MaxwellMrks/Neon-Plasma-Tube-Entropy-Source-/3195khz.jpg

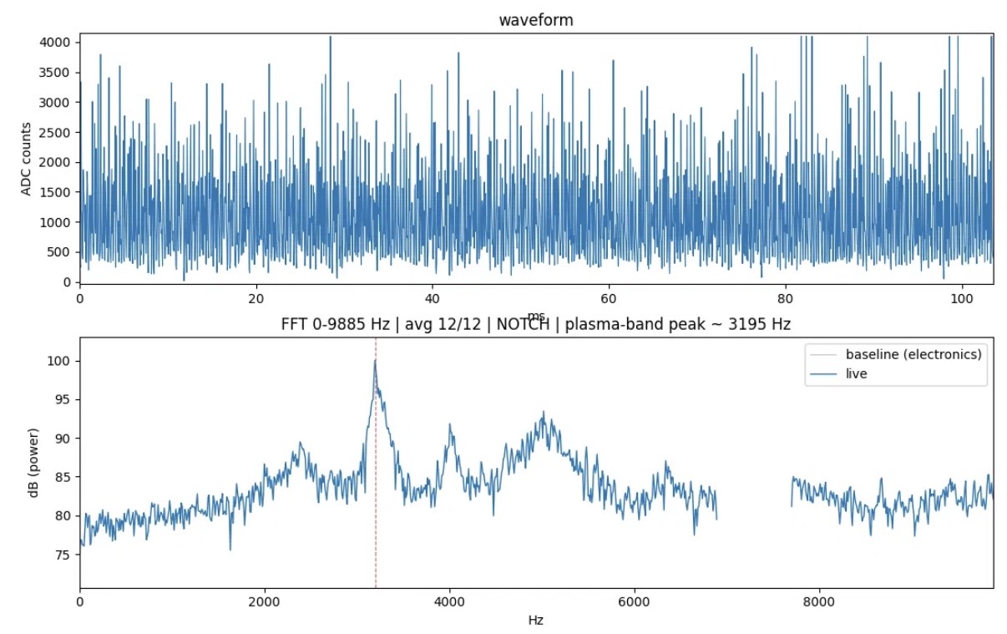
3195khz.jpg
