MaxwellMrks/Neon-Plasma-Tube-Entropy-Source-/1787427748118-20be8ff6-90f8-49e6-af36-aabe3dccb726_1.jpg

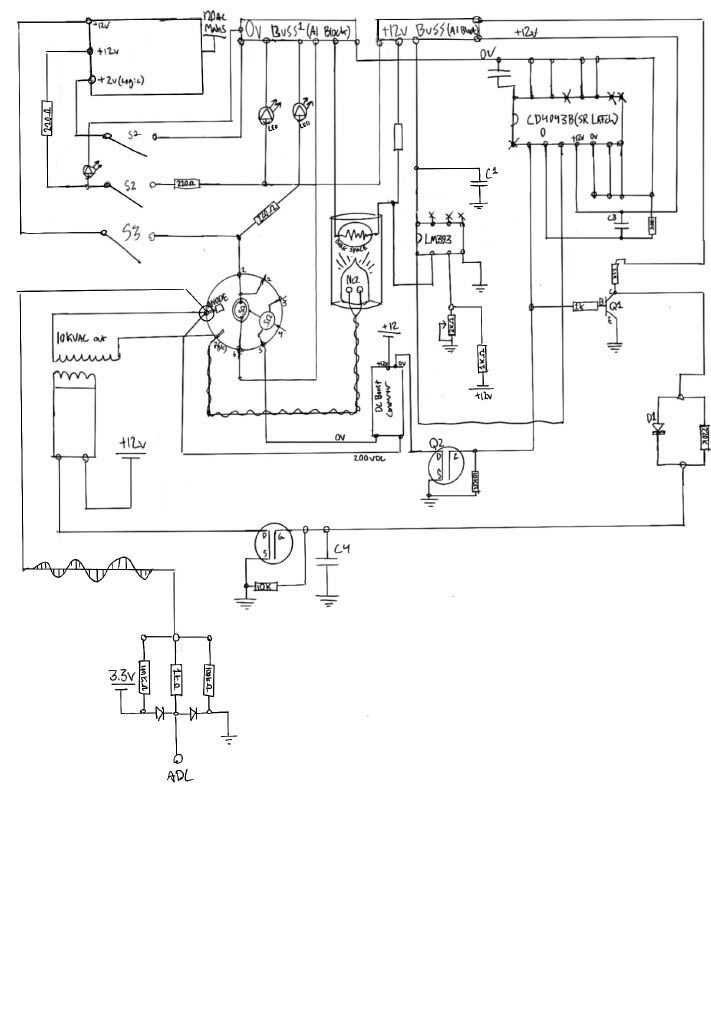
1787427748118-20be8ff6-90f8-49e6-af36-aabe3dccb726_1.jpg
