MaxwellMrks/Neon-Plasma-Tube-Entropy-Source-/CompletedRNG2.jpg

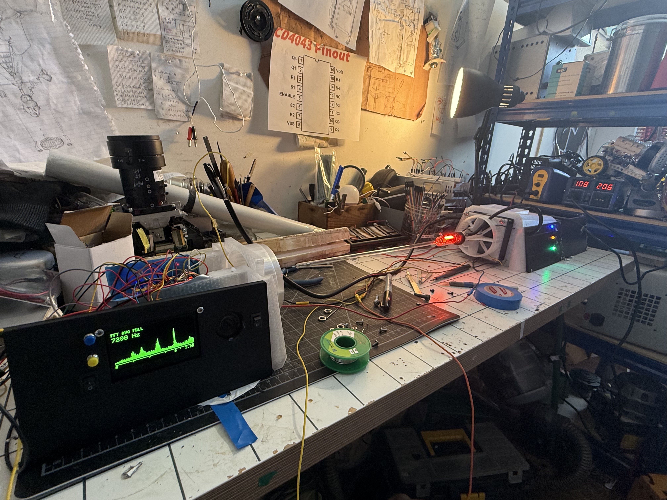
CompletedRNG2.jpg
