MaxwellMrks/Neon-Plasma-Tube-Entropy-Source-/gshpic3.jpg

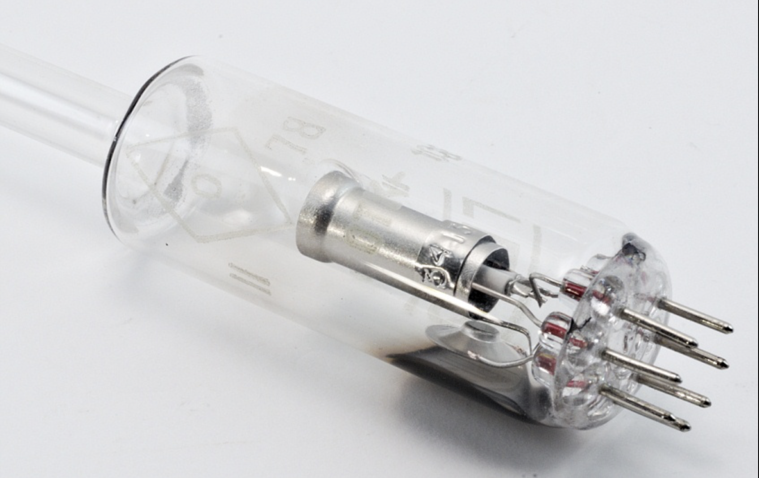
gshpic3.jpg
