MaxwellMrks/Neon-Plasma-Tube-Entropy-Source-/gshpic4.jpg

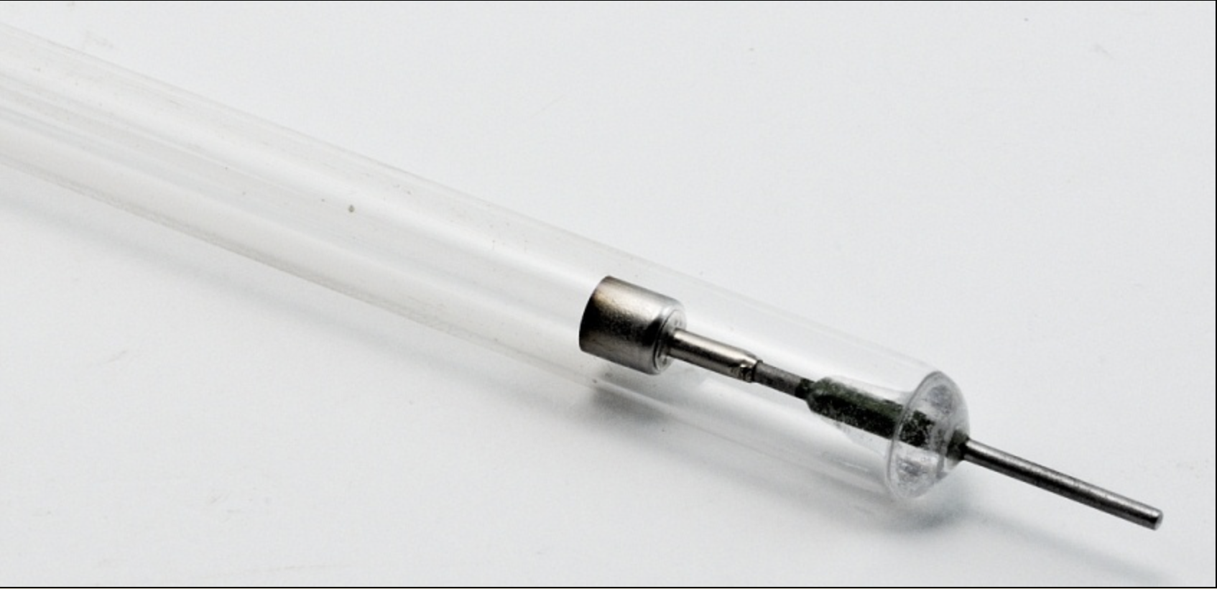
gshpic4.jpg
