MaxwellMrks/Neon-Plasma-Tube-Entropy-Source-/(commit log)

2026-07-08 Create C++ [For esp32]
2026-07-09 Rename Untitled_Artwork.pdf to Schematic for logic level circuitry
2026-07-09 Rename C++ [For esp32] to GSH_2ESP32.ino
